rombrew/phobia-pcb/README.md

This repository contains schematic and printed circuit board design files of
the PMC. There is KiCad project. Refer to the PMC repository for details.
