rombrew/phobia-pcb/rev5a/pmc-schematic-rev5a.pdf

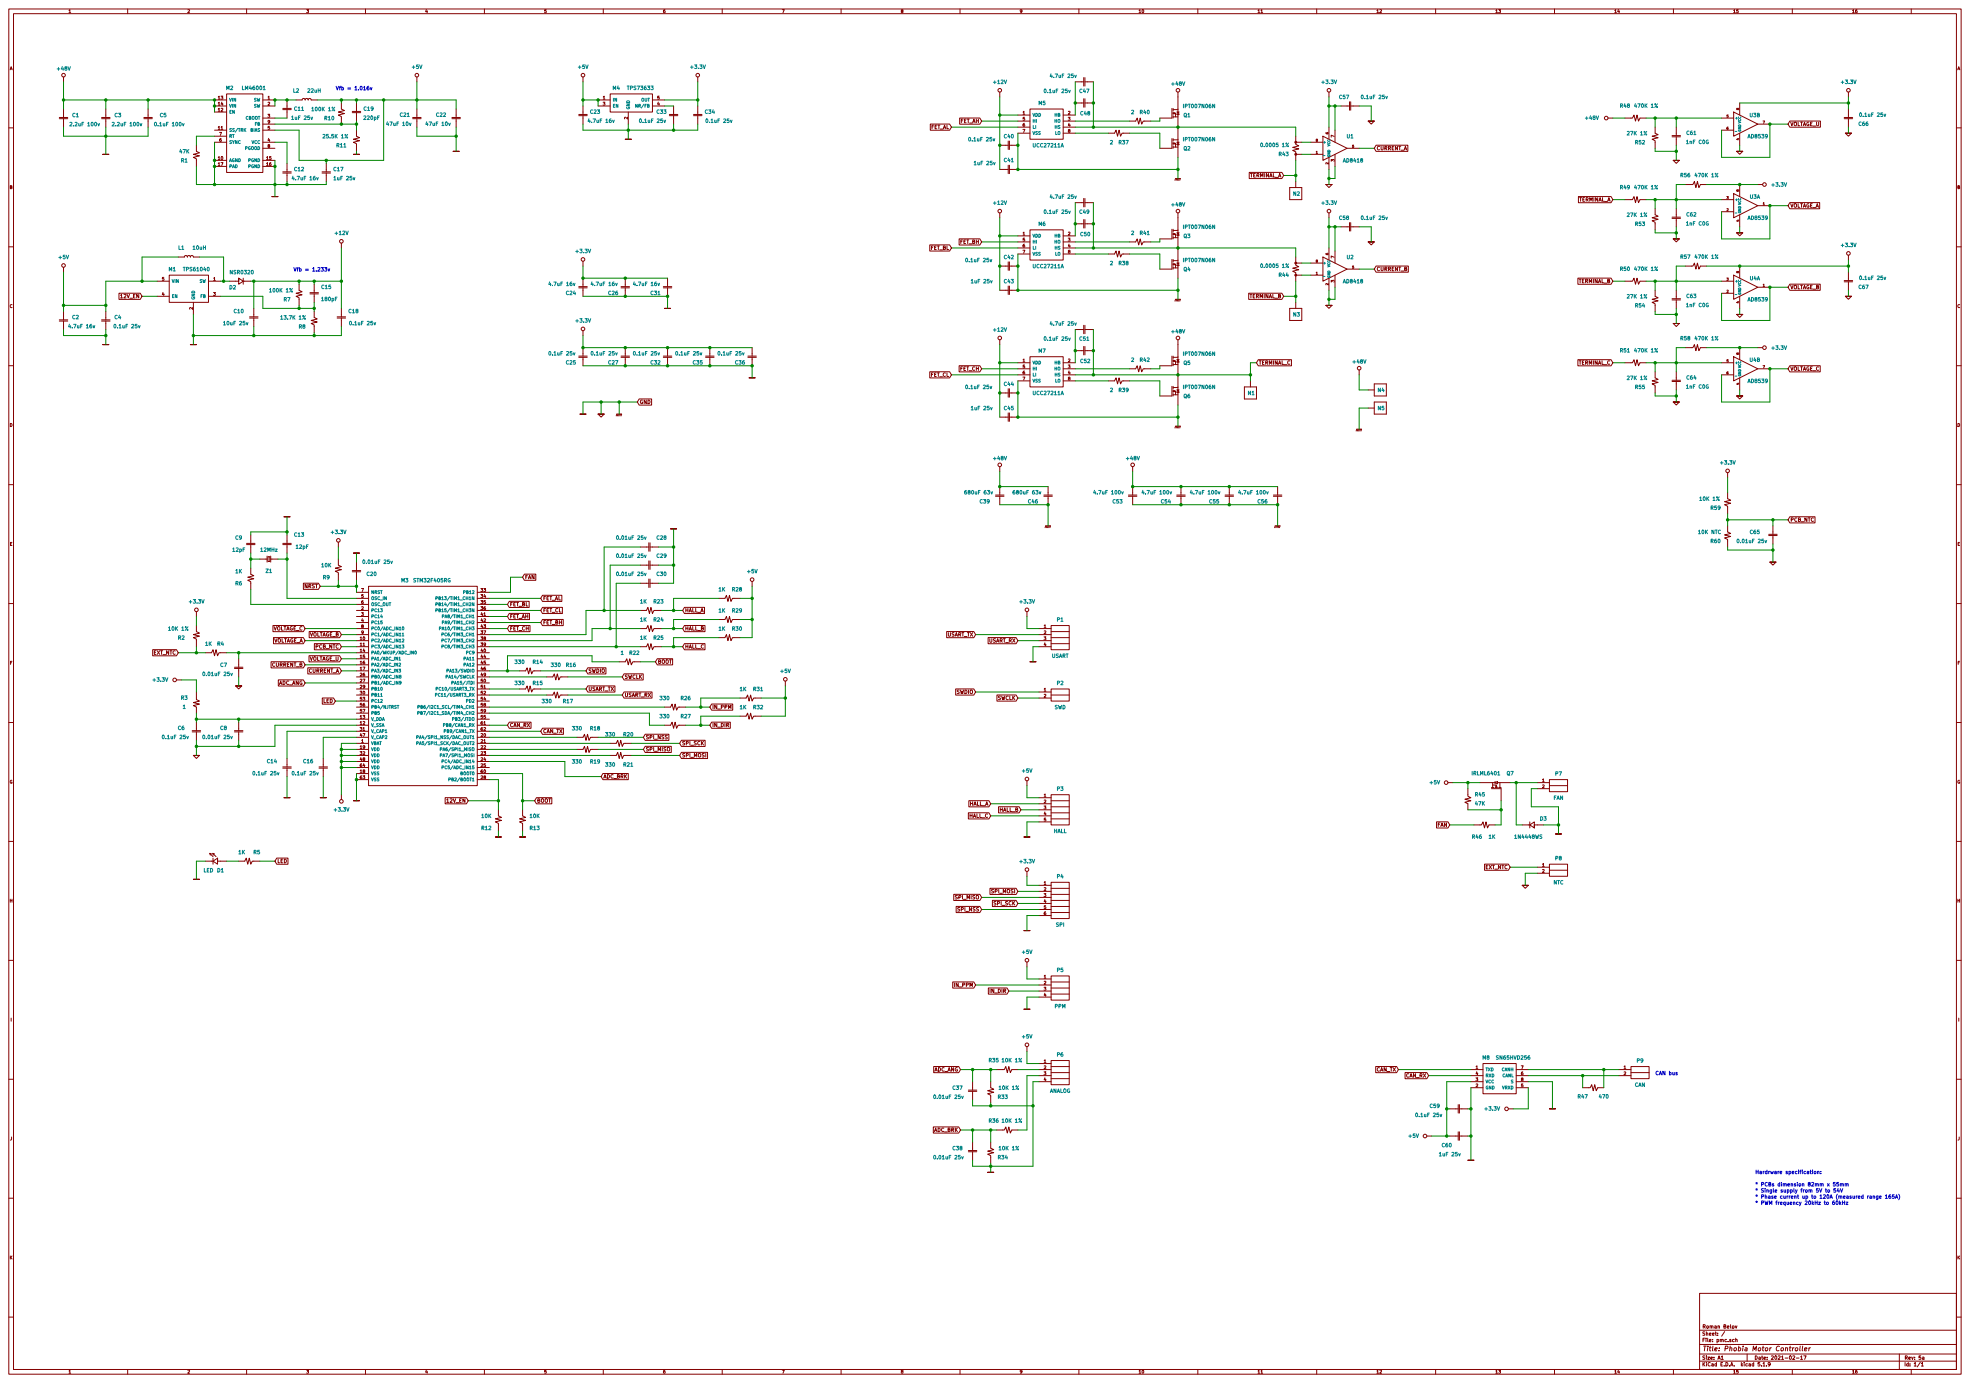
[picture p1: page 1]

2 EN 3 NR/FB 4 OUT 5 M4 TPS73633 GND

* PCBs dimension 82mm x 55mm
* Single supply from 5V to 54V
* Phase current up to 120A (measured range 165A)
* PWM frequency 20kHz to 60kHz

File: pmc.sch Sheet: / Roman Belov

Id: 1/1 Title: Phobia Motor Controller
