rombrew/phobia-pcb/rev5b/pmc-schematic-rev5b.pdf

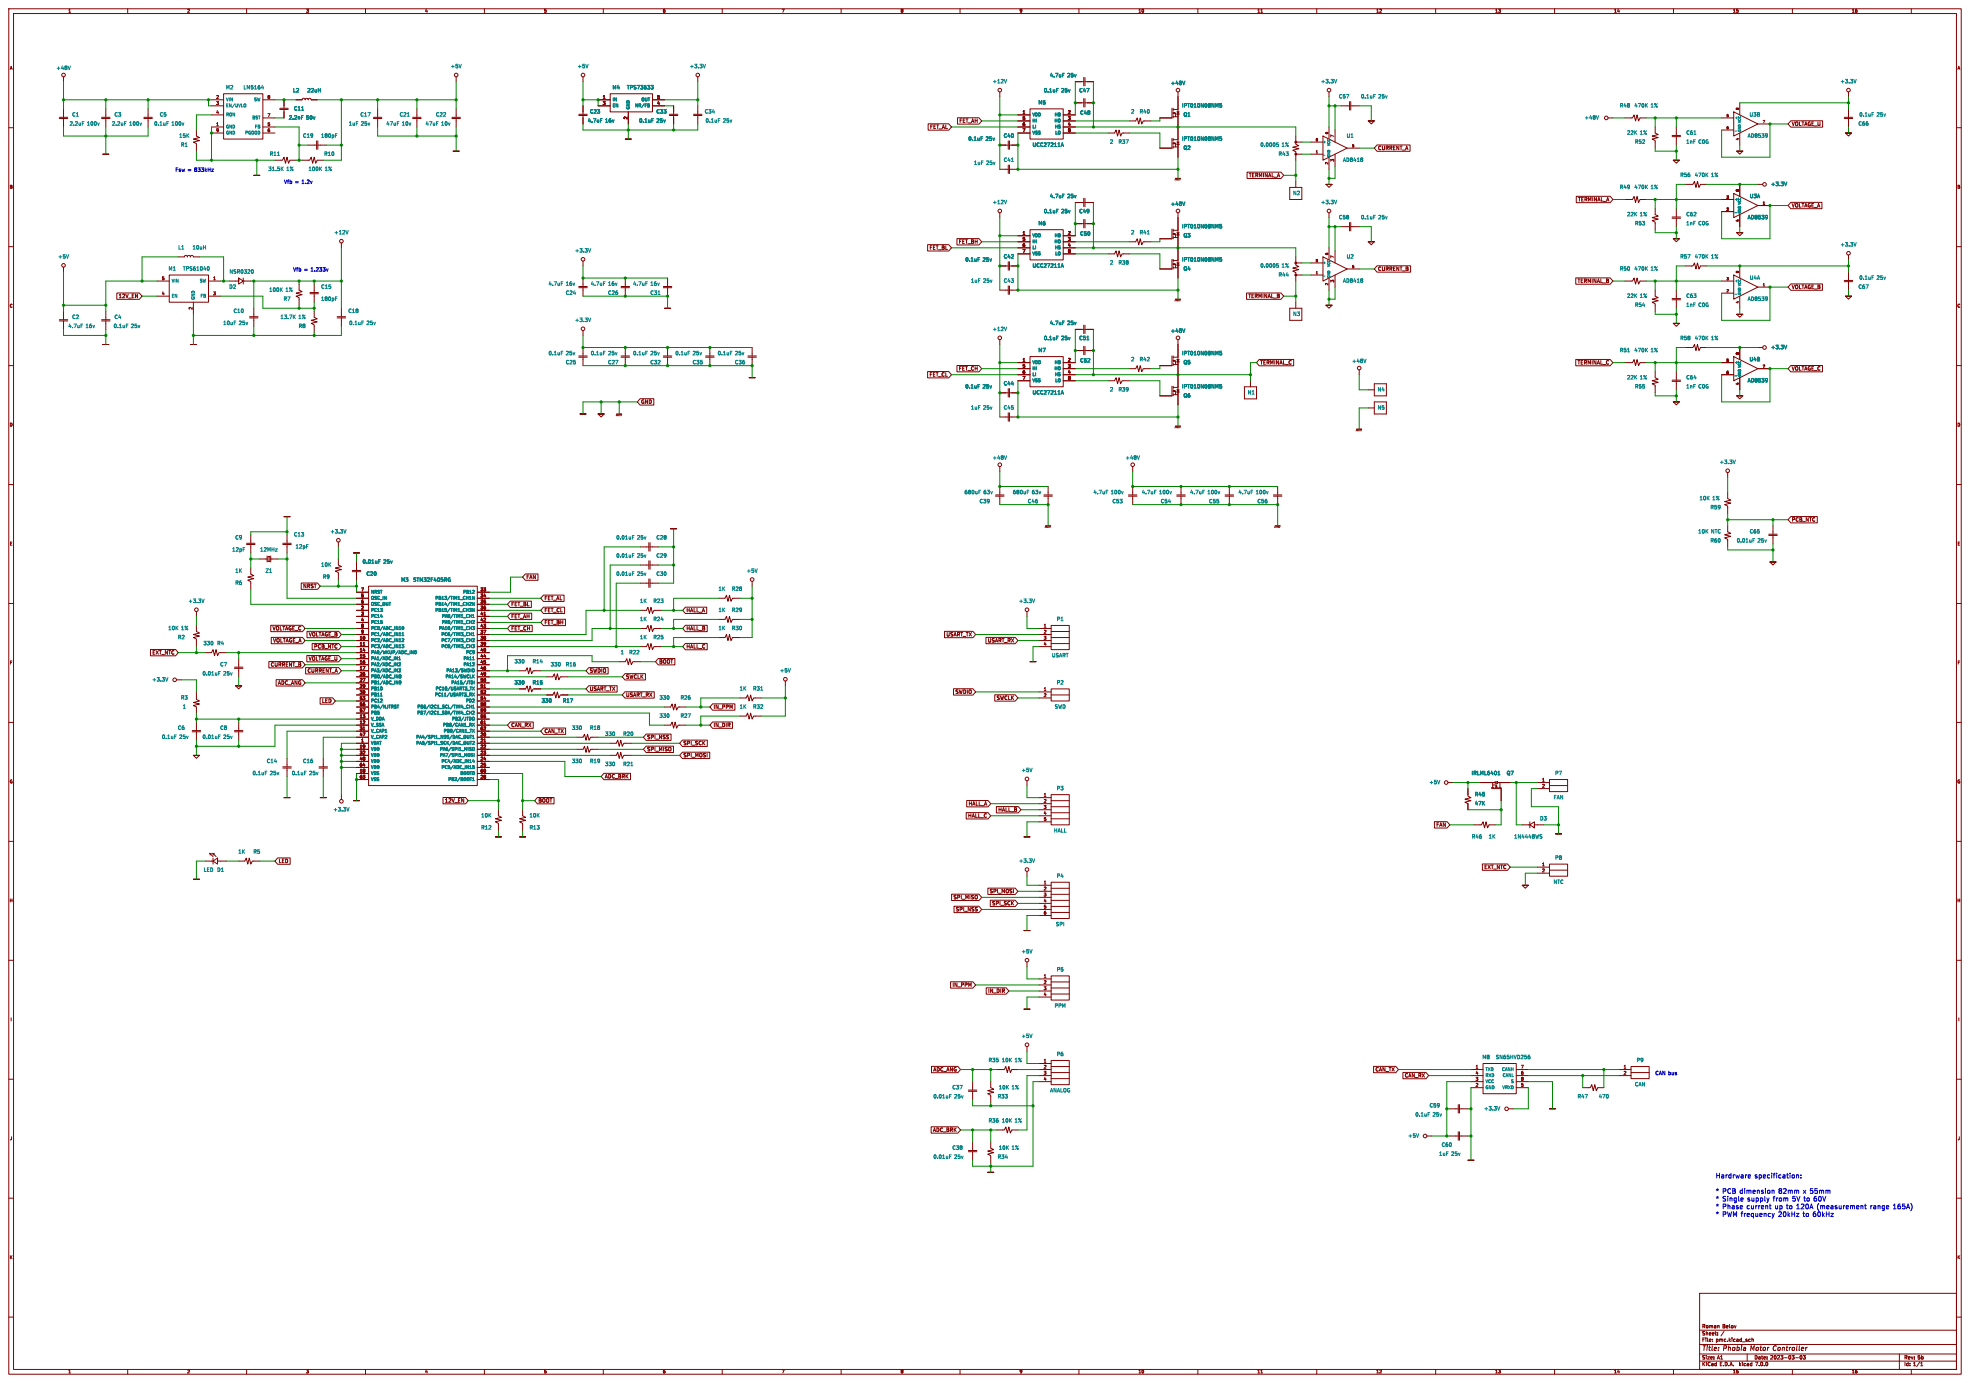
[picture p2: page 1]

2 EN 3 NR/FB 4 OUT 5 M4 TPS73633

2 EN 3 NR/FB 4 OUT 5 C23

* Single supply from 5V to 60V
* Phase current up to 120A (measurement range 165A) * PWM frequency 20kHz to 60kHz
