rombrew/phobia-pcb/rev5a/pmc-drawing-rev5a.pdf

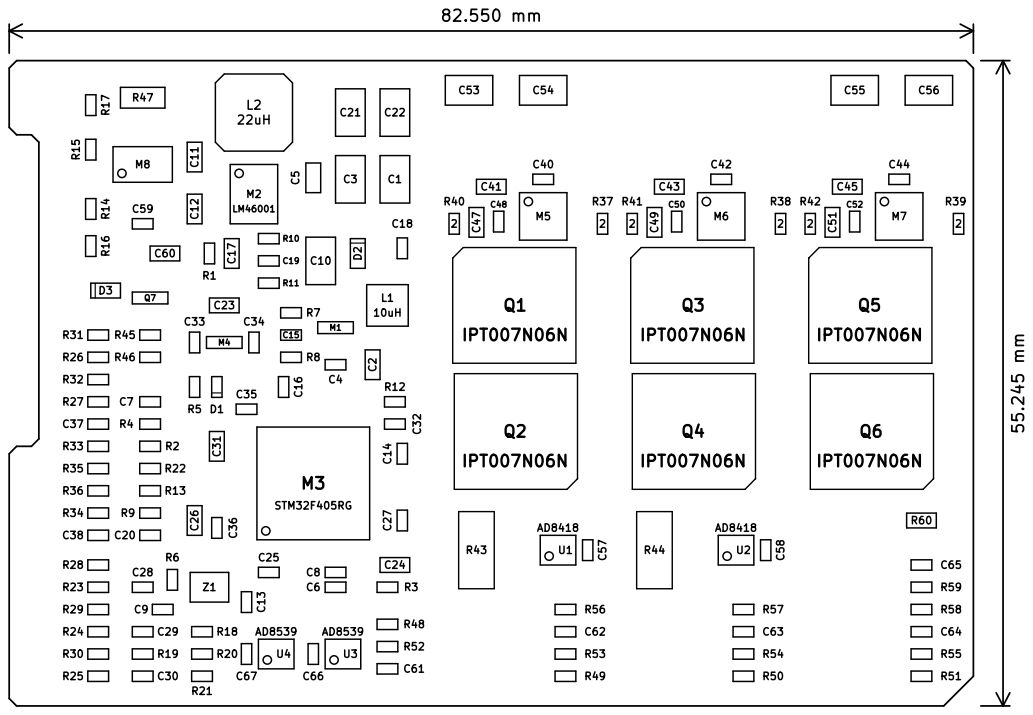
[picture p3: page 1]
