rombrew/phobia-pcb/rev5b/pmc-drawing-rev5b.pdf

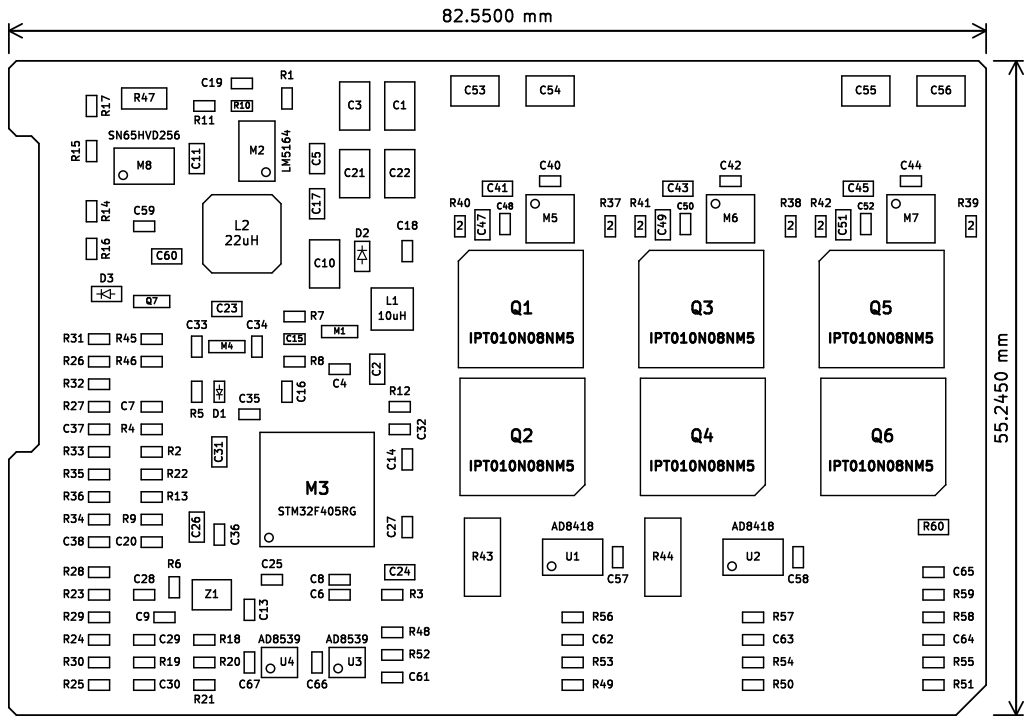
[picture p4: page 1]
