rombrew/phobia-pcb/pmc.kicad_sch

## KiCad design pmc.kicad_sch (2023-03-04)

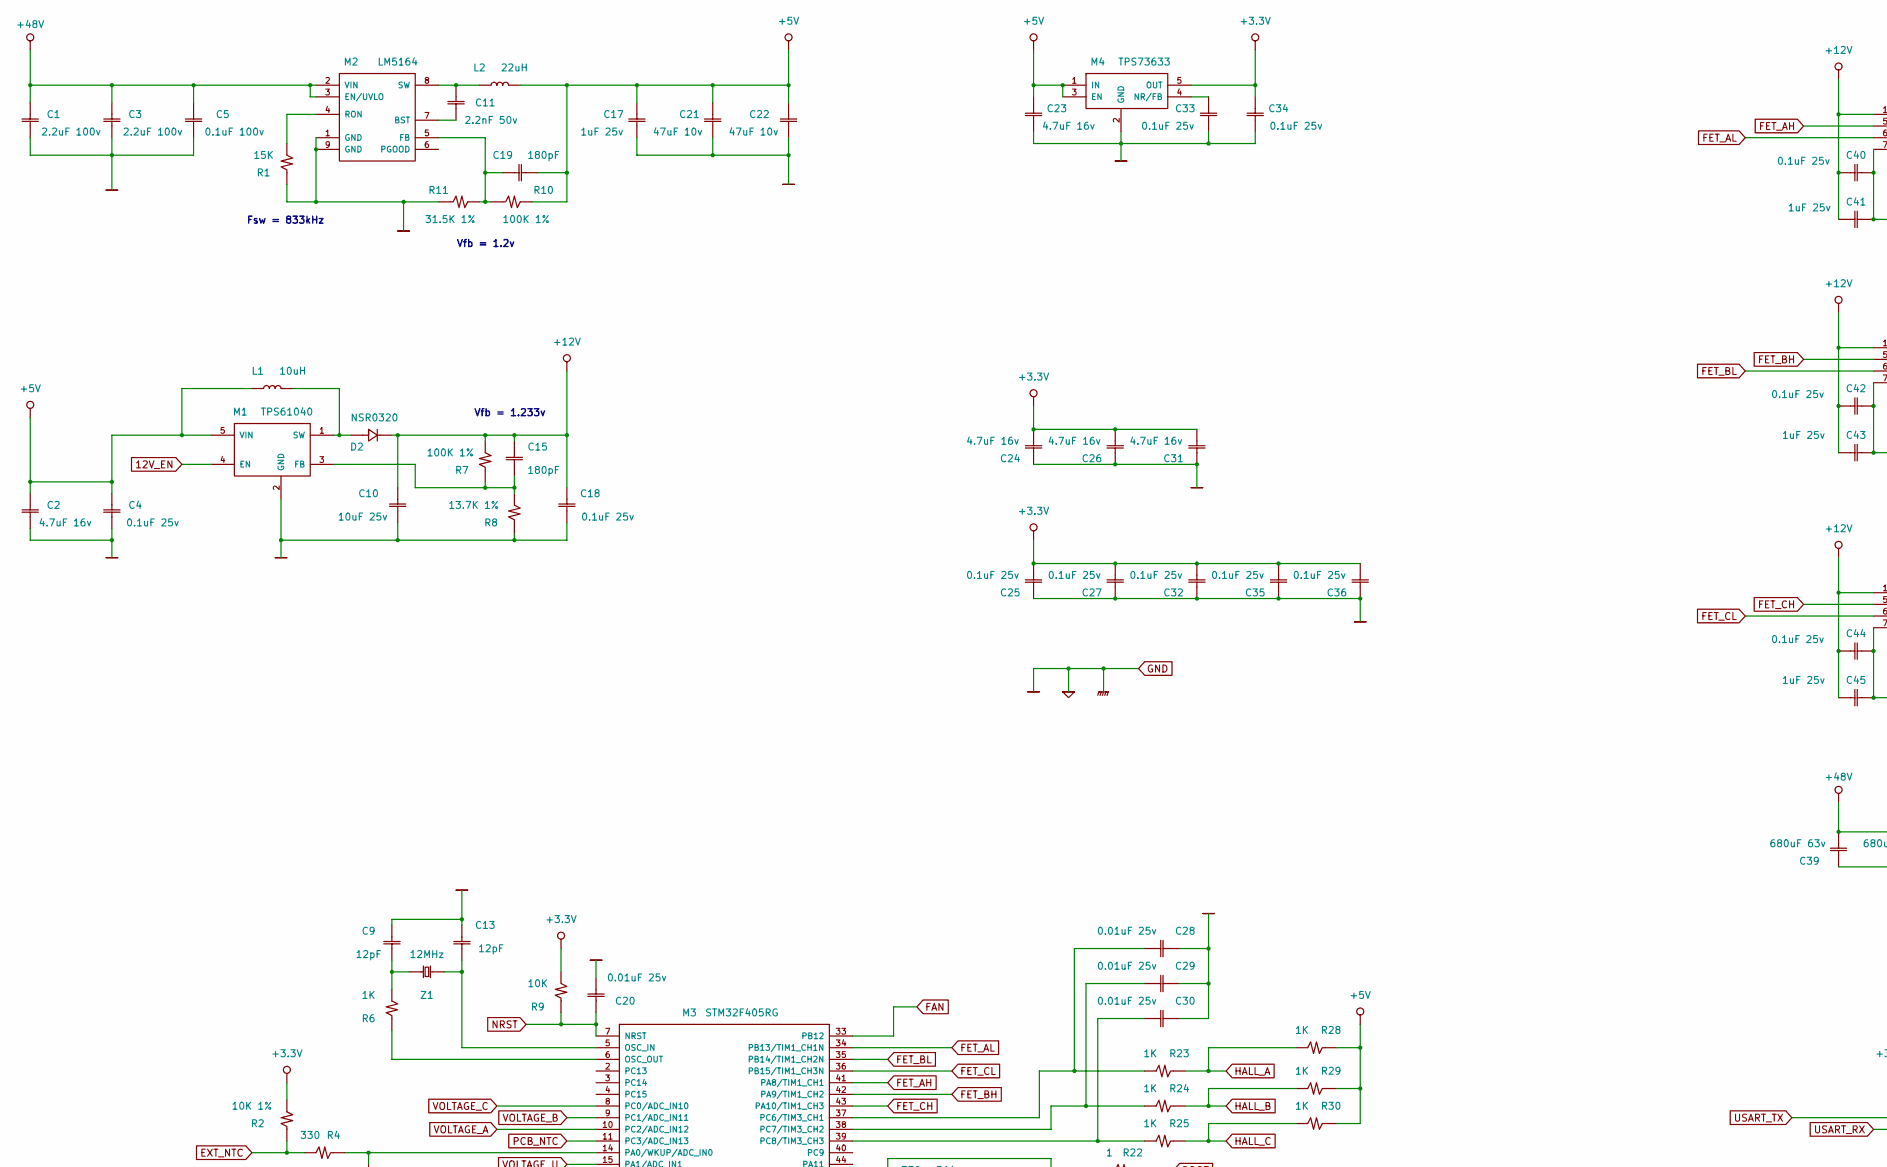
[picture p5: schematic pmc.kicad_sch, part in row 1, column 1]

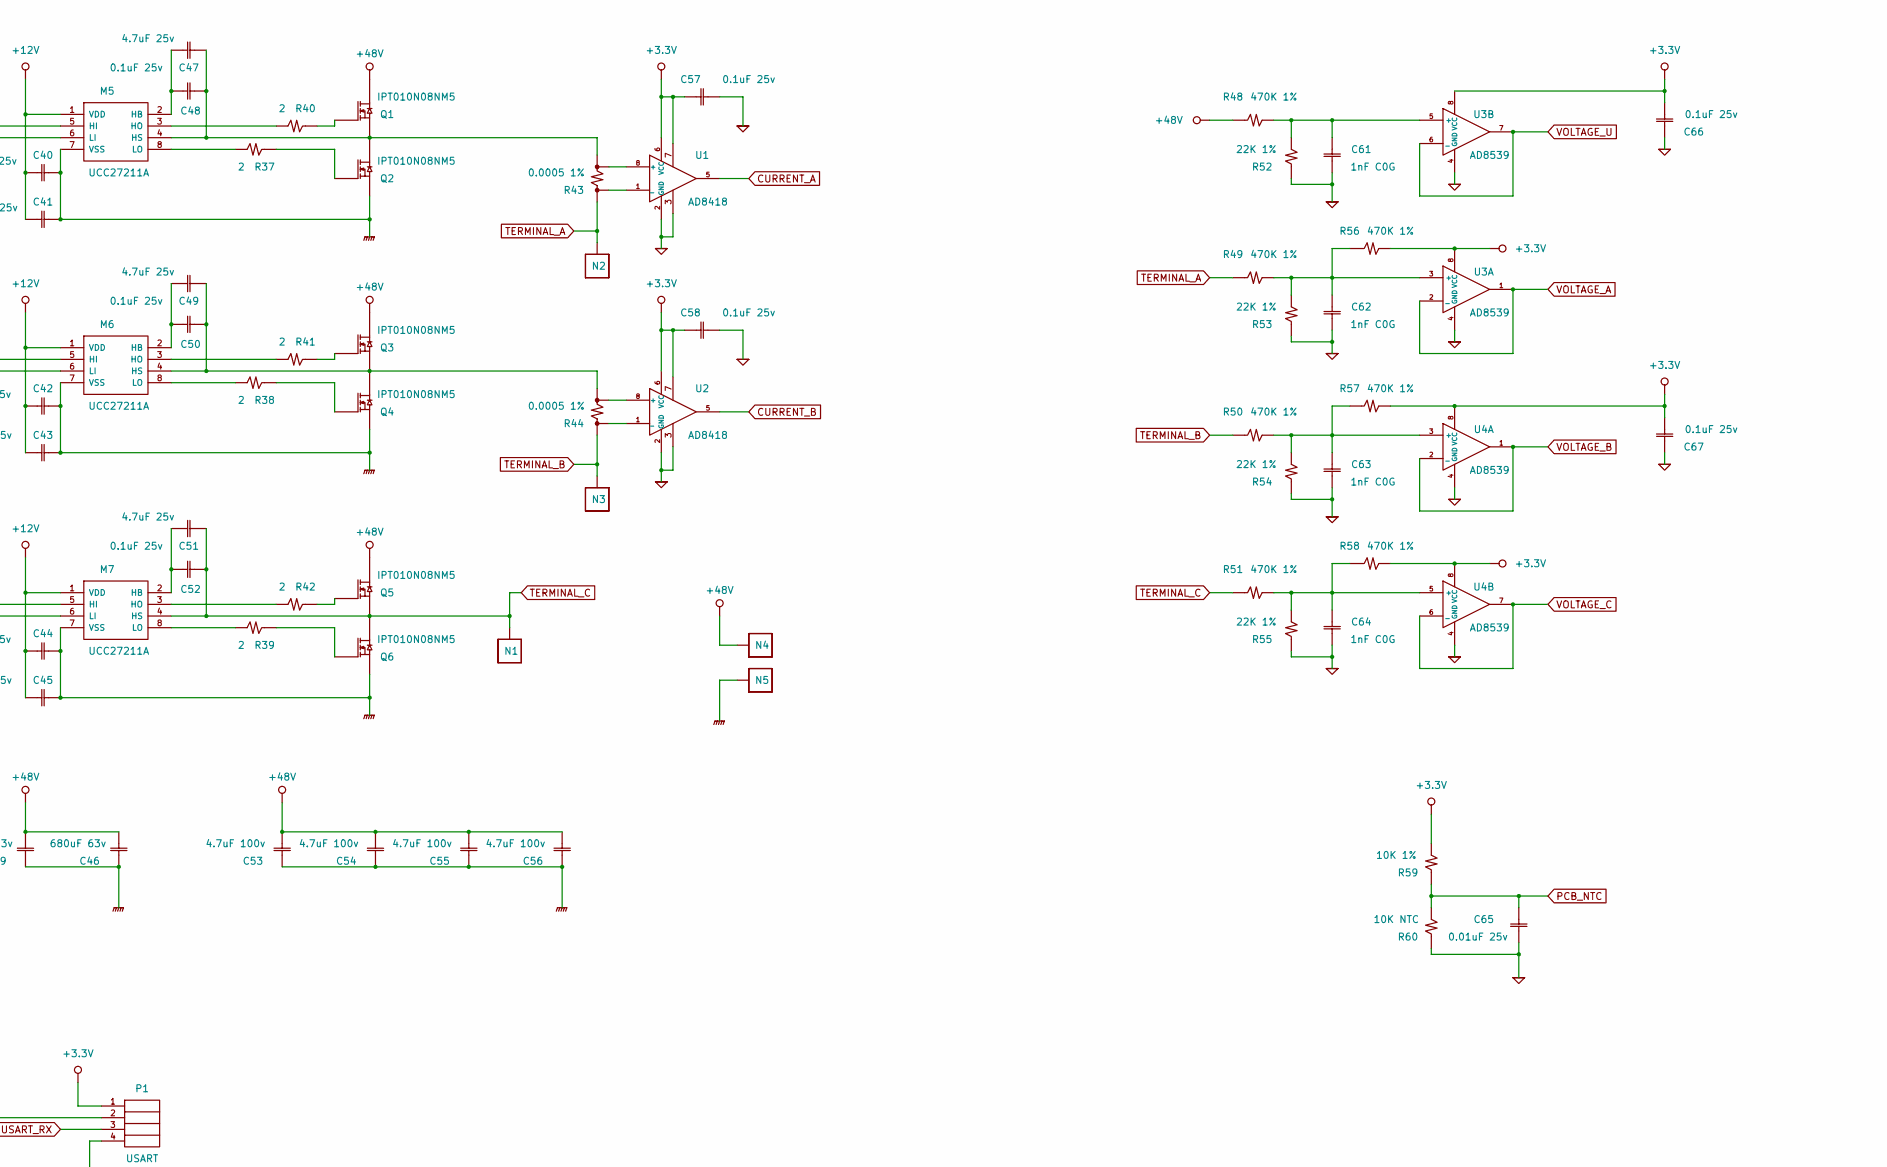
[picture p6: schematic pmc.kicad_sch, part in row 1, column 2]

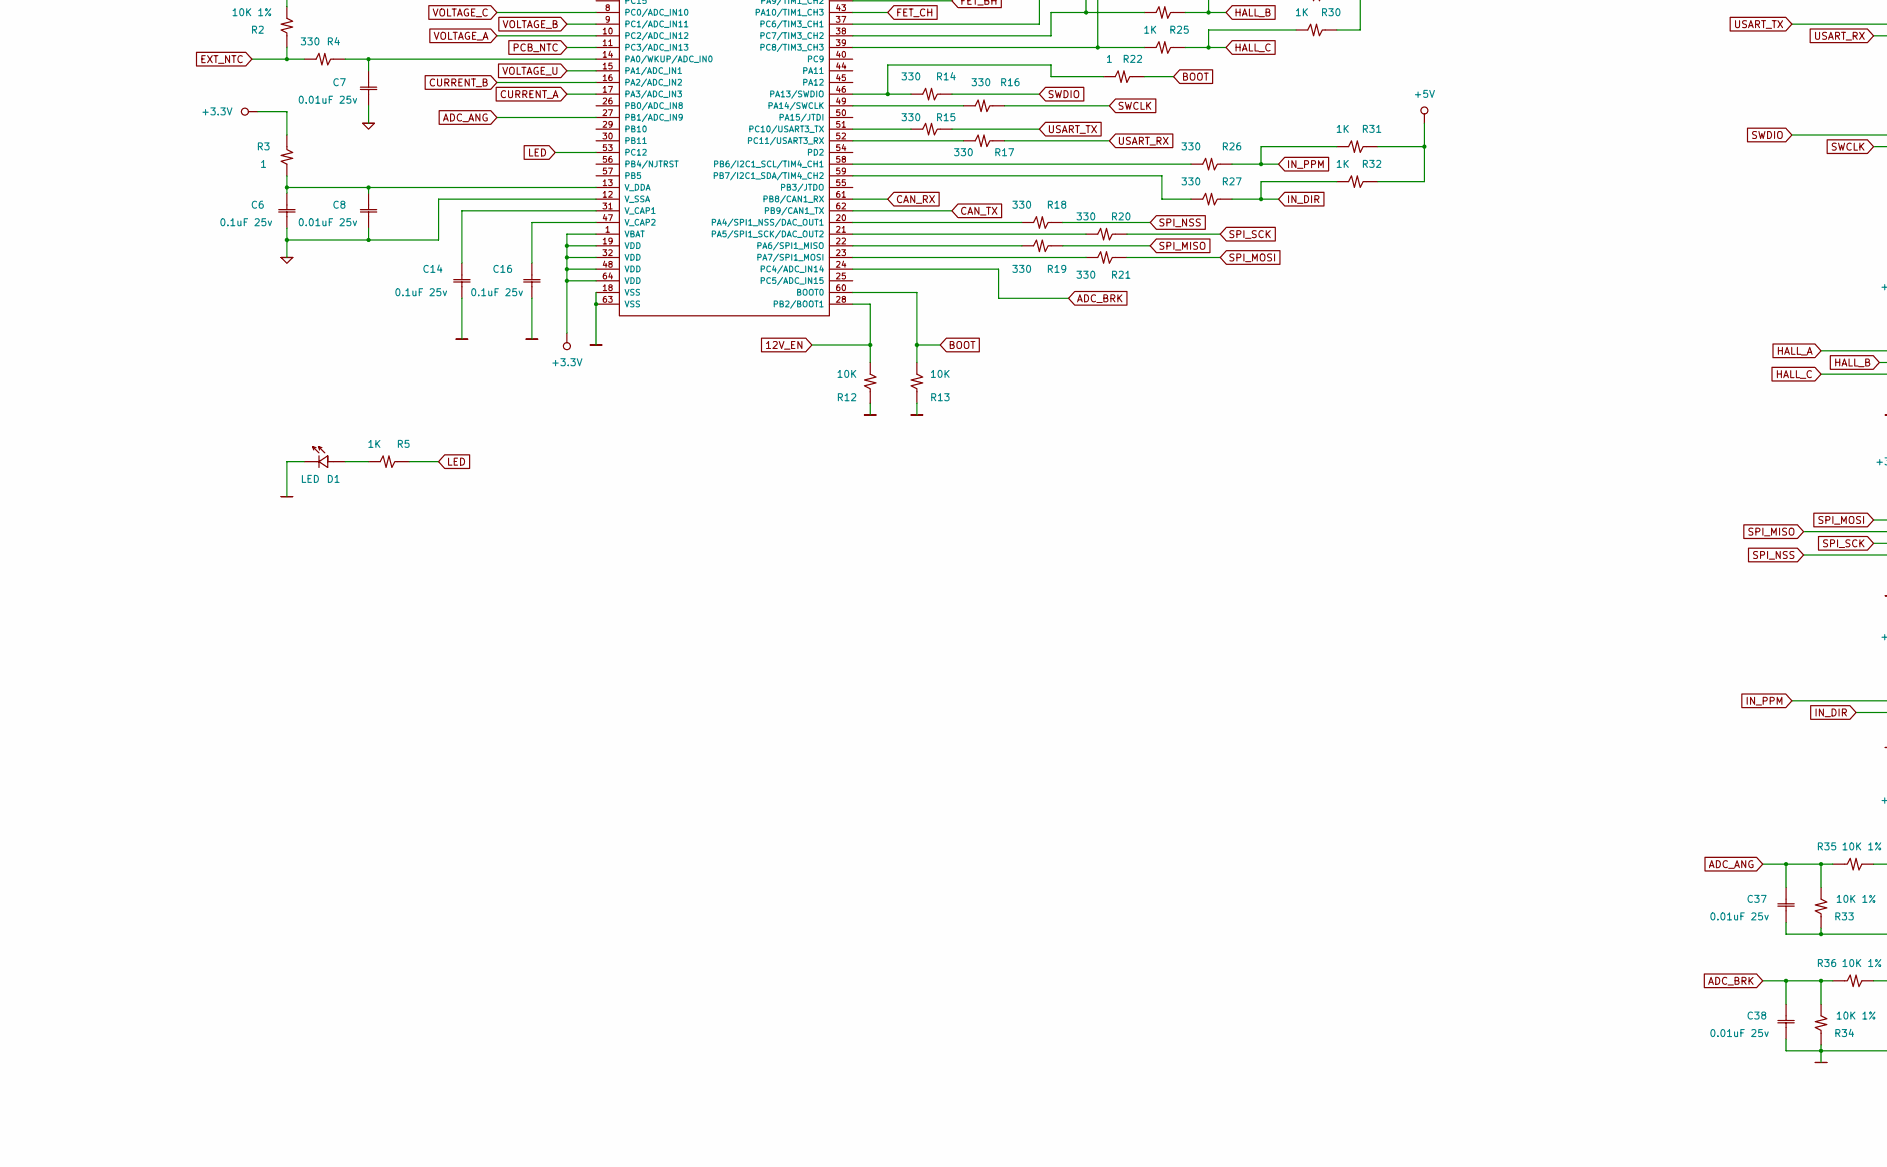
[picture p7: schematic pmc.kicad_sch, part in row 2, column 1]

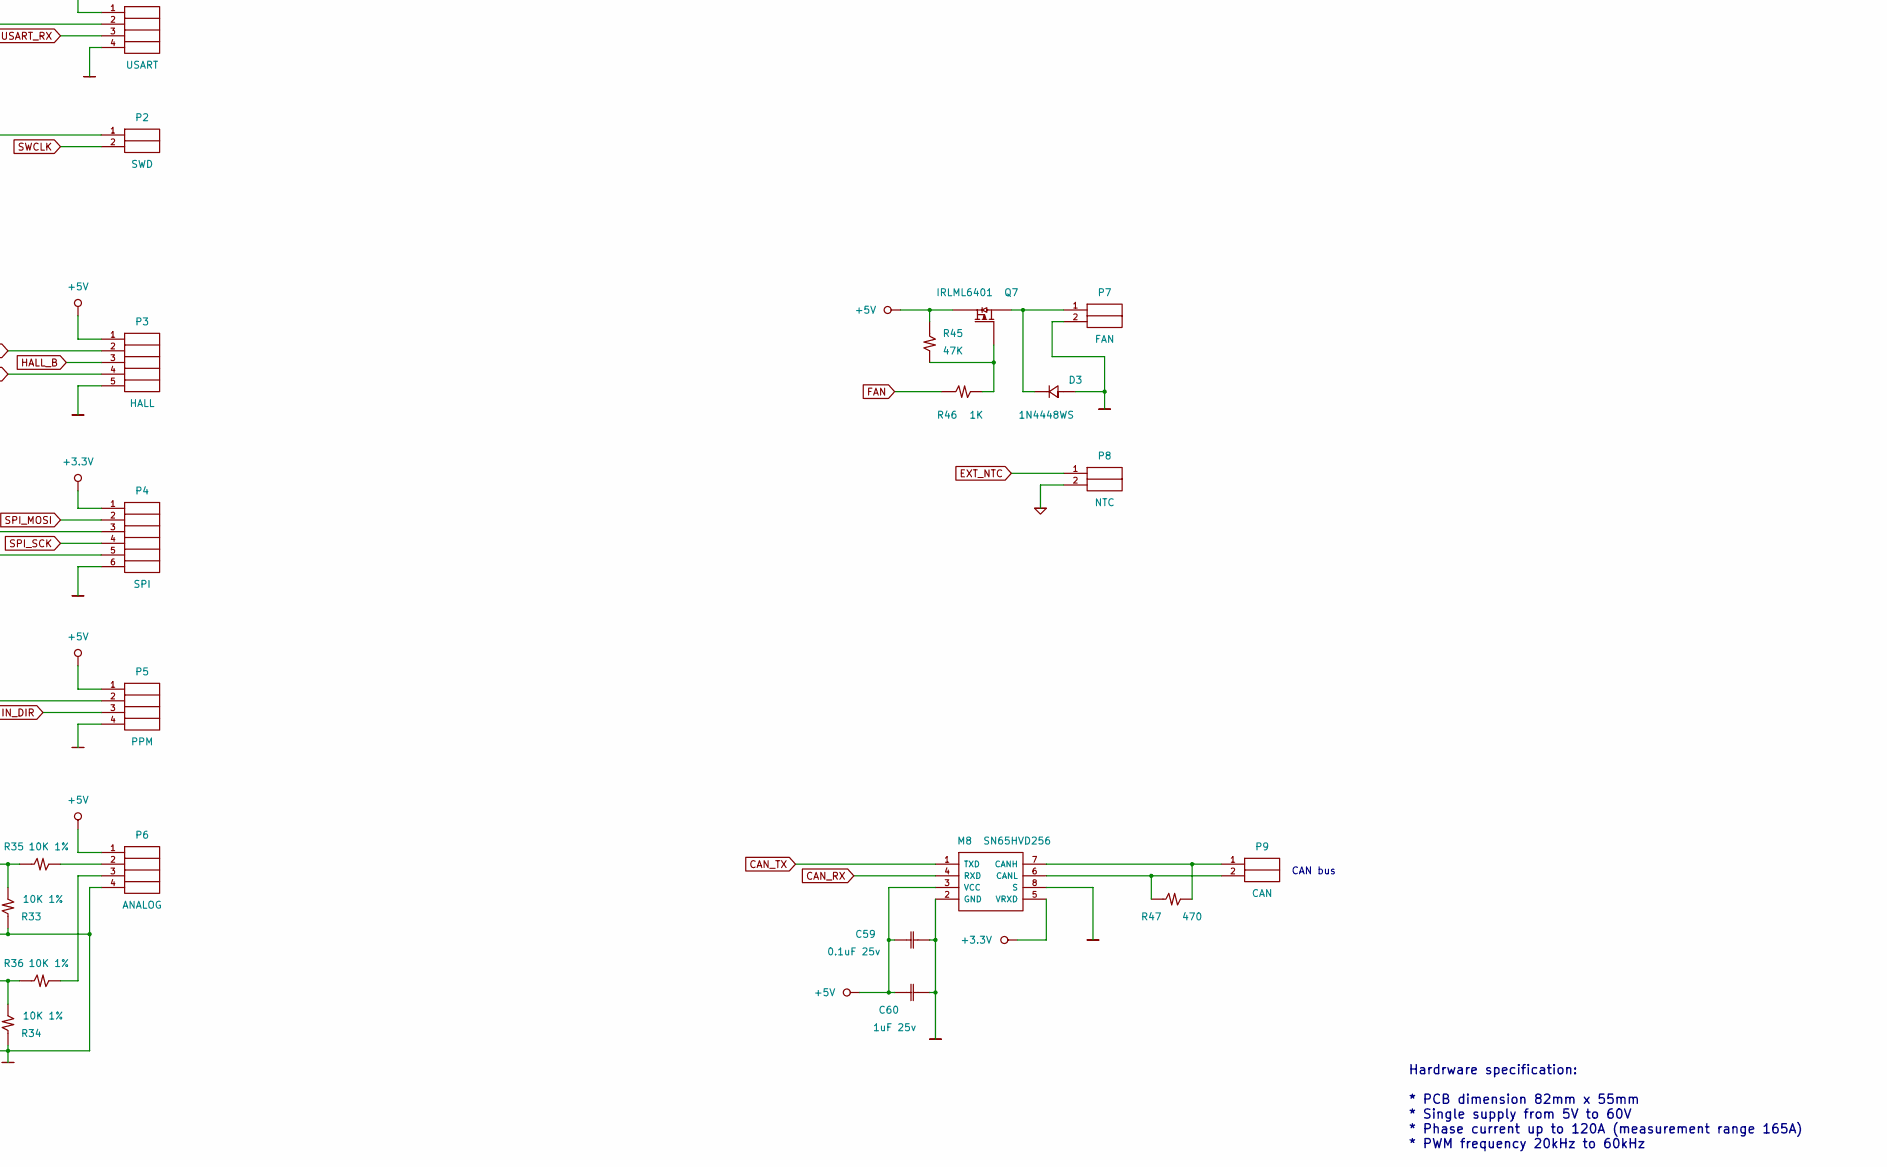
[picture p8: schematic pmc.kicad_sch, part in row 2, column 2]

Parts:
C1, C3: 2.2uF 100v; SM-1210
C2, C23, C24, C26, C31: 4.7uF 16v; SM-0805
C4, C6, C14, C16, C18, C25, C27, C32, C33, C34, C35, C36, C40, C42, C44, C48, C50, C52, C57, C58, C59, C66, C67: 0.1uF 25v; SM-0603
C5: 0.1uF 100v; SM-0805
C7, C8, C20, C28, C29, C30, C37, C38, C65: 0.01uF 25v; SM-0603
C9, C13: 12pF; SM-0603
C10: 10uF 25v; SM-1210
C11: 2.2nF 50v; SM-0805
C15, C19: 180pF; SM-0603
C17, C41, C43, C45, C60: 1uF 25v; SM-0805
C21, C22: 47uF 10v; SM-1210
C39, C46: 680uF 63v; CE-135
C47, C49, C51: 4.7uF 25v; SM-0805
C53, C54, C55, C56: 4.7uF 100v; SM-1210
C61, C62, C63, C64: 1nF C0G; SM-0603
D1: LED; SM-0603
D2: NSR0320; SM-0805
D3: 1N4448WS; SM-0805
L1: 10uH; COIL-3
L2: 22uH; COIL-8
M1: TPS61040; SOT-23-5
M2: LM5164; PDSO-8
M3: STM32F405RG; LQFP-64
M4: TPS73633; SOT-23-5
M5, M6, M7: UCC27211A; SON-8
M8: SN65HVD256; SOIC-8
N1, N2, N3, N4, N5: PAD4; PLS-1
P1: USART; PLS-4
P2: SWD; PLS-2
P3: HALL; PLS-5
P4: SPI; PLS-6
P5: PPM; PLS-4
P6: ANALOG; PLS-4
P7: FAN; PLS-2
P8: NTC; PLS-2
P9: CAN; PLS-2
Q1, Q2, Q3, Q4, Q5, Q6: IPT010N08NM5; PG-HSOF-8
Q7: IRLML6401; SOT-23
R1: 15K; SM-0603
R2, R33, R34, R35, R36, R59: 10K 1%; SM-0603
R3, R22: 1; SM-0603
R4, R14, R15, R16, R17, R18, R19, R20, R21, R26, R27: 330; SM-0603
R5, R6, R23, R24, R25, R28, R29, R30, R31, R32, R46: 1K; SM-0603
R7, R10: 100K 1%; SM-0603
R8: 13.7K 1%; SM-0603
R9, R12, R13: 10K; SM-0603
R11: 31.5K 1%; SM-0603
R37, R38, R39, R40, R41, R42: 2; SM-0603
R43, R44: 0.0005 1%; LR2512-4
R45: 47K; SM-0603
R47: 470; SM-1206
R48, R49, R50, R51, R56, R57, R58: 470K 1%; SM-0603
R52, R53, R54, R55: 22K 1%; SM-0603
R60: 10K NTC; SM-0805
U1, U2: AD8418; SOIC-8
U3, U4: AD8539; MSOP-8
Z1: 12MHz; SM-Z3225

Connections:
12V_EN: M1.4 (EN), M3.28 (PB2/BOOT1), R12.2
+3.3V: C24.1, C25.1, C26.1, C27.1, C31.1, C32.1, C34.1, C35.1, C36.1, C57.2, C58.2, C66.1, C67.1, M3.1 (VBAT), M3.19 (VDD), M3.32 (VDD), M3.48 (VDD), M3.64 (VDD), M4.5 (OUT), M8.5 (VRXD), P1.1, P4.1, R2.2, R3.1, R9.2, R56.2, R57.2, R58.2, R59.2, U1.6 (VCC), U1.7, U2.6 (VCC), U2.7, U3.8 (VCC), U4.8 (VCC)
+5V: C2.1, C4.1, C17.1, C19.1, C21.1, C22.1, C23.1, C59.2, C60.2, L1.1, L2.2, M1.5 (VIN), M4.1 (IN), M4.3 (EN), M8.3 (VCC), P3.1, P5.1, P6.1, Q7.2 (S), R10.2, R28.1, R29.1, R30.1, R31.1, R32.1, R45.1
+12V: C10.1, C15.1, C18.1, C40.2, C41.1, C42.2, C43.2, C44.2, C45.2, D2.1, M5.1 (VDD), M6.1 (VDD), M7.1 (VDD), R7.2
+48V: C1.2, C3.2, C5.2, C39.1, C46.1, C53.1, C54.1, C55.1, C56.1, M2.2 (VIN), M2.3 (EN/UVLO), N4.1, Q1.3 (D), Q3.3 (D), Q5.3 (D), R48.1
ADC_ANG: C37.2, M3.27 (PB1/ADC_IN9), R33.2, R35.1
ADC_BRK: C38.2, M3.24 (PC4/ADC_IN14), R34.2, R36.1
AGND: C1.1, C2.2, C3.1, C4.2, C5.1, C6.2, C7.1, C8.2, C9.1, C10.2, C13.1, C14.2, C16.2, C17.2, C18.2, C20.1, C21.2, C22.2, C23.2, C24.2, C25.2, C26.2, C27.2, C28.2, C29.2, C30.2, C31.2, C32.2, C33.2, C34.2, C35.2, C36.2, C37.1, C38.1, C39.2, C40.1, C41.2, C42.1, C43.1, C44.1, C45.1, C46.2, C53.2, C54.2, C55.2, C56.2, C57.1, C58.1, C59.1, C60.1, C61.2, C62.2, C63.2, C64.2, C65.1, C66.2, C67.2, D1.1, D3.2, M1.2 (GND), M2.1 (GND), M2.9 (GND), M3.12 (V_SSA), M3.18 (VSS), M3.63 (VSS), M4.2 (GND), M5.7 (VSS), M6.7 (VSS), M7.7 (VSS), M8.2 (GND), M8.8 (S), N5.1, P1.4, P3.5, P4.6, P5.4, P6.4, P7.2, P8.2, Q2.2 (S), Q4.2 (S), Q6.2 (S), R1.1, R8.1, R11.1, R12.1, R13.1, R33.1, R34.1, R52.1, R53.1, R54.1, R55.1, R60.1, U1.2 (GND), U1.3, U2.2 (GND), U2.3, U3.4 (GND), U4.4 (GND)
BOOT: M3.60 (BOOT0), R13.2, R22.1
CAN_RX: M3.61 (PB8/CAN1_RX), M8.4 (RXD)
CAN_TX: M3.62 (PB9/CAN1_TX), M8.1 (TXD)
CURRENT_A: M3.17 (PA3/ADC_IN3), U1.5
CURRENT_B: M3.16 (PA2/ADC_IN2), U2.5
EXT_NTC: P8.1, R2.1, R4.2
FAN: M3.33 (PB12), R46.1
FET_AH: M3.41 (PA8/TIM1_CH1), M5.5 (HI)
FET_AL: M3.34 (PB13/TIM1_CH1N), M5.6 (LI)
FET_BH: M3.42 (PA9/TIM1_CH2), M6.5 (HI)
FET_BL: M3.35 (PB14/TIM1_CH2N), M6.6 (LI)
FET_CH: M3.43 (PA10/TIM1_CH3), M7.5 (HI)
FET_CL: M3.36 (PB15/TIM1_CH3N), M7.6 (LI)
HALL_A: P3.2, R23.1, R28.2
HALL_B: P3.3, R24.1, R29.2
HALL_C: P3.4, R25.1, R30.2
IN_DIR: P5.3, R27.1, R32.2
IN_PPM: P5.2, R26.1, R31.2
LED: M3.53 (PC12), R5.1
NRST: C20.2, M3.7 (NRST), R9.1
unnamed: C6.1, C8.1, M3.13 (V_DDA), R3.2
unnamed: C7.2, M3.14 (PA0/WKUP/ADC_IN0), R4.1
unnamed: C9.2, R6.2, Z1.1
unnamed: C11.1, L2.1, M2.8 (SW)
unnamed: C11.2, M2.7 (BST)
unnamed: C13.2, M3.5 (OSC_IN), Z1.2
unnamed: C14.1, M3.31 (V_CAP1)
unnamed: C15.2, M1.3 (FB), R7.1, R8.2
unnamed: C16.1, M3.47 (V_CAP2)
unnamed: C19.2, M2.5 (FB), R10.1, R11.2
unnamed: C28.1, M3.37 (PC6/TIM3_CH1), R23.2
unnamed: C29.1, M3.38 (PC7/TIM3_CH2), R24.2
unnamed: C30.1, M3.39 (PC8/TIM3_CH3), R25.2
unnamed: C33.1, M4.4 (NR/FB)
unnamed: C47.1, C48.1, M5.4 (HS), Q1.2 (S), Q2.3 (D), R43.1
unnamed: C47.2, C48.2, M5.2 (HB)
unnamed: C49.1, C50.1, M6.4 (HS), Q3.2 (S), Q4.3 (D), R44.1
unnamed: C49.2, C50.2, M6.2 (HB)
unnamed: C51.2, C52.2, M7.2 (HB)
unnamed: C61.1, R48.2, R52.2, U3.5 (+)
unnamed: C62.1, R49.2, R53.2, R56.1, U3.3 (+)
unnamed: C63.1, R50.2, R54.2, R57.1, U4.3 (+)
unnamed: C64.1, R51.2, R55.2, R58.1, U4.5 (+)
unnamed: D1.2, R5.2
unnamed: D2.2, L1.2, M1.1 (SW)
unnamed: D3.1, P7.1, Q7.3 (D)
unnamed: M2.4 (RON), R1.2
unnamed: M3.6 (OSC_OUT), R6.1
unnamed: M3.20 (PA4/SPI1_NSS/DAC_OUT1), R18.2
unnamed: M3.21 (PA5/SPI1_SCK/DAC_OUT2), R20.2
unnamed: M3.22 (PA6/SPI1_MISO), R19.2
unnamed: M3.23 (PA7/SPI1_MOSI), R21.2
unnamed: M3.46 (PA13/SWDIO), R14.2, R22.2
unnamed: M3.49 (PA14/SWCLK), R16.2
unnamed: M3.51 (PC10/USART3_TX), R15.2
unnamed: M3.52 (PC11/USART3_RX), R17.2
unnamed: M3.58 (PB6/I2C1_SCL/TIM4_CH1), R26.2
unnamed: M3.59 (PB7/I2C1_SDA/TIM4_CH2), R27.2
unnamed: M5.3 (HO), R40.2
unnamed: M5.8 (LO), R37.2
unnamed: M6.3 (HO), R41.2
unnamed: M6.8 (LO), R38.2
unnamed: M7.3 (HO), R42.2
unnamed: M7.8 (LO), R39.2
unnamed: M8.6 (CANL), P9.2, R47.1
unnamed: M8.7 (CANH), P9.1, R47.2
unnamed: P6.2, R35.2
unnamed: P6.3, R36.2
unnamed: Q1.1 (G), R40.1
unnamed: Q2.1 (G), R37.1
unnamed: Q3.1 (G), R41.1
unnamed: Q4.1 (G), R38.1
unnamed: Q5.1 (G), R42.1
unnamed: Q6.1 (G), R39.1
unnamed: Q7.1 (G), R45.2, R46.2
unnamed: R43.3, U1.8 (+)
unnamed: R43.4, U1.1 (_)
unnamed: R44.3, U2.8 (+)
unnamed: R44.4, U2.1 (_)
PCB_NTC: C65.2, M3.11 (PC3/ADC_IN13), R59.1, R60.2
SPI_MISO: P4.3, R19.1
SPI_MOSI: P4.2, R21.1
SPI_NSS: P4.5, R18.1
SPI_SCK: P4.4, R20.1
SWCLK: P2.2, R16.1
SWDIO: P2.1, R14.1
TERMINAL_A: N2.1, R43.2, R49.1
TERMINAL_B: N3.1, R44.2, R50.1
TERMINAL_C: C51.1, C52.1, M7.4 (HS), N1.1, Q5.2 (S), Q6.3 (D), R51.1
USART_RX: P1.3, R17.1
USART_TX: P1.2, R15.1
VOLTAGE_A: M3.10 (PC2/ADC_IN12), U3.1, U3.2 (_)
VOLTAGE_B: M3.9 (PC1/ADC_IN11), U4.1, U4.2 (_)
VOLTAGE_C: M3.8 (PC0/ADC_IN10), U4.6 (_), U4.7
VOLTAGE_U: M3.15 (PA1/ADC_IN1), U3.6 (_), U3.7

Notes on the sheet:
Vfb = 1.2v
Vfb = 1.233v
Fsw = 833kHz
CAN bus
Hardrware specification: * PCB dimension 82mm x 55mm * Single supply from 5V to 60V * Phase current up to 120A (measurement range 165A) * PWM frequency 20kHz to 60kHz
